JohnGENZ/695-Waffle-Meter/WaffleMeter V3 Board Layout/SpeechAnalyserV3.pdf

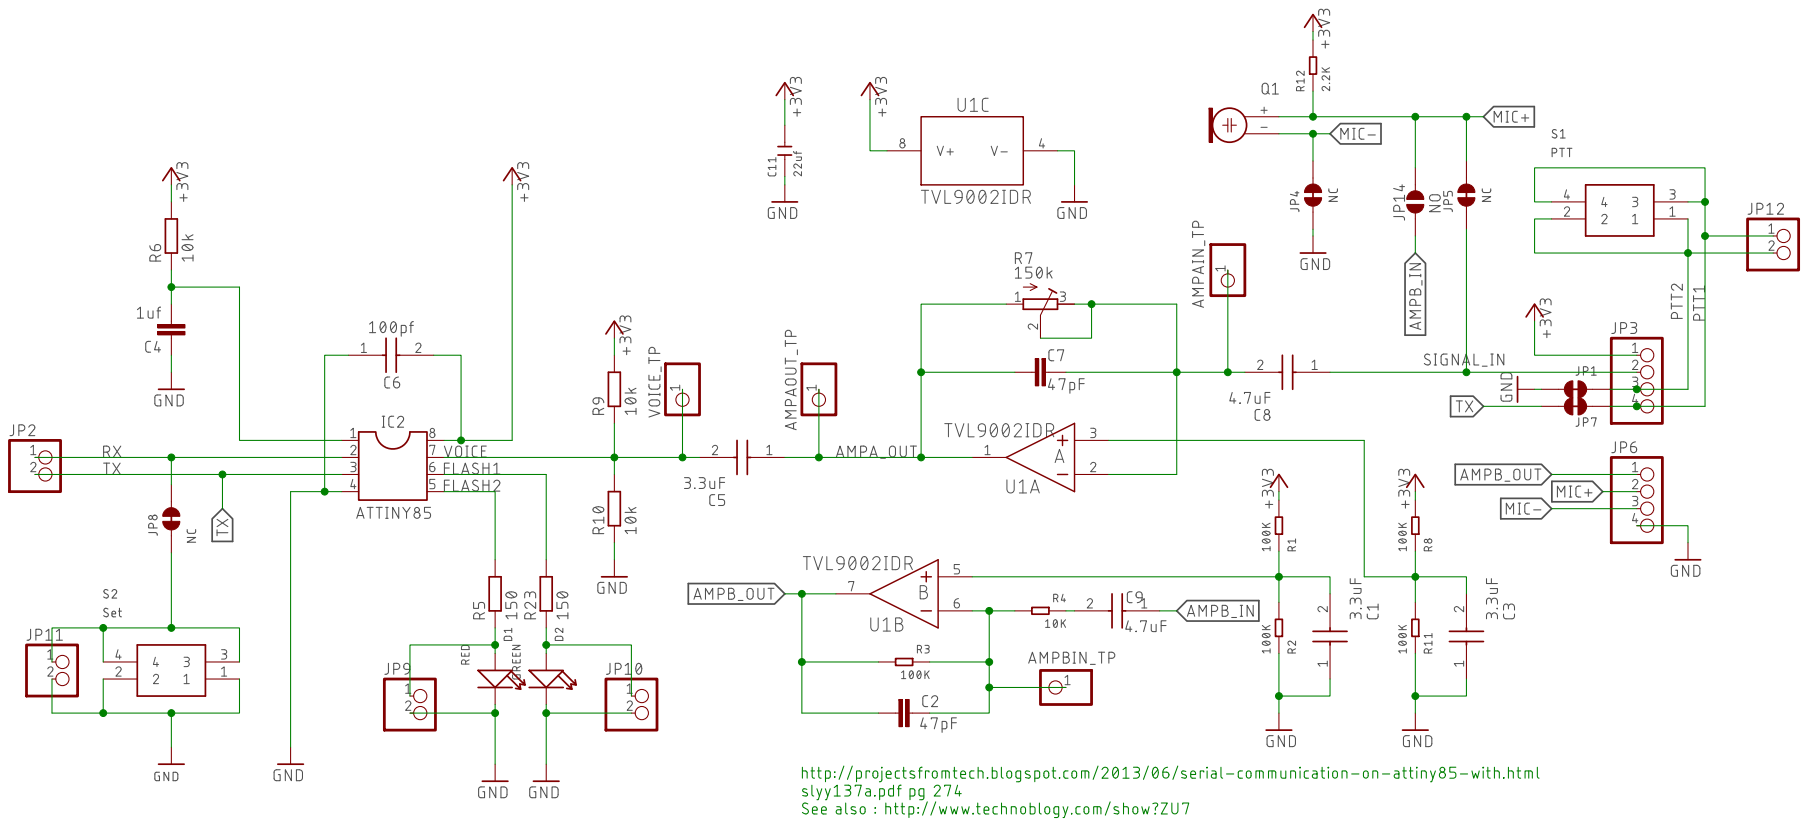
[picture p1: page 1]
