JohnGENZ/695-Waffle-Meter/WaffleMeter V3 Board Layout/SpeechAnalyserV3.brd

## EAGLE design WaffleMeter V3 Board Layout/SpeechAnalyserV3.brd (2020-05-19)

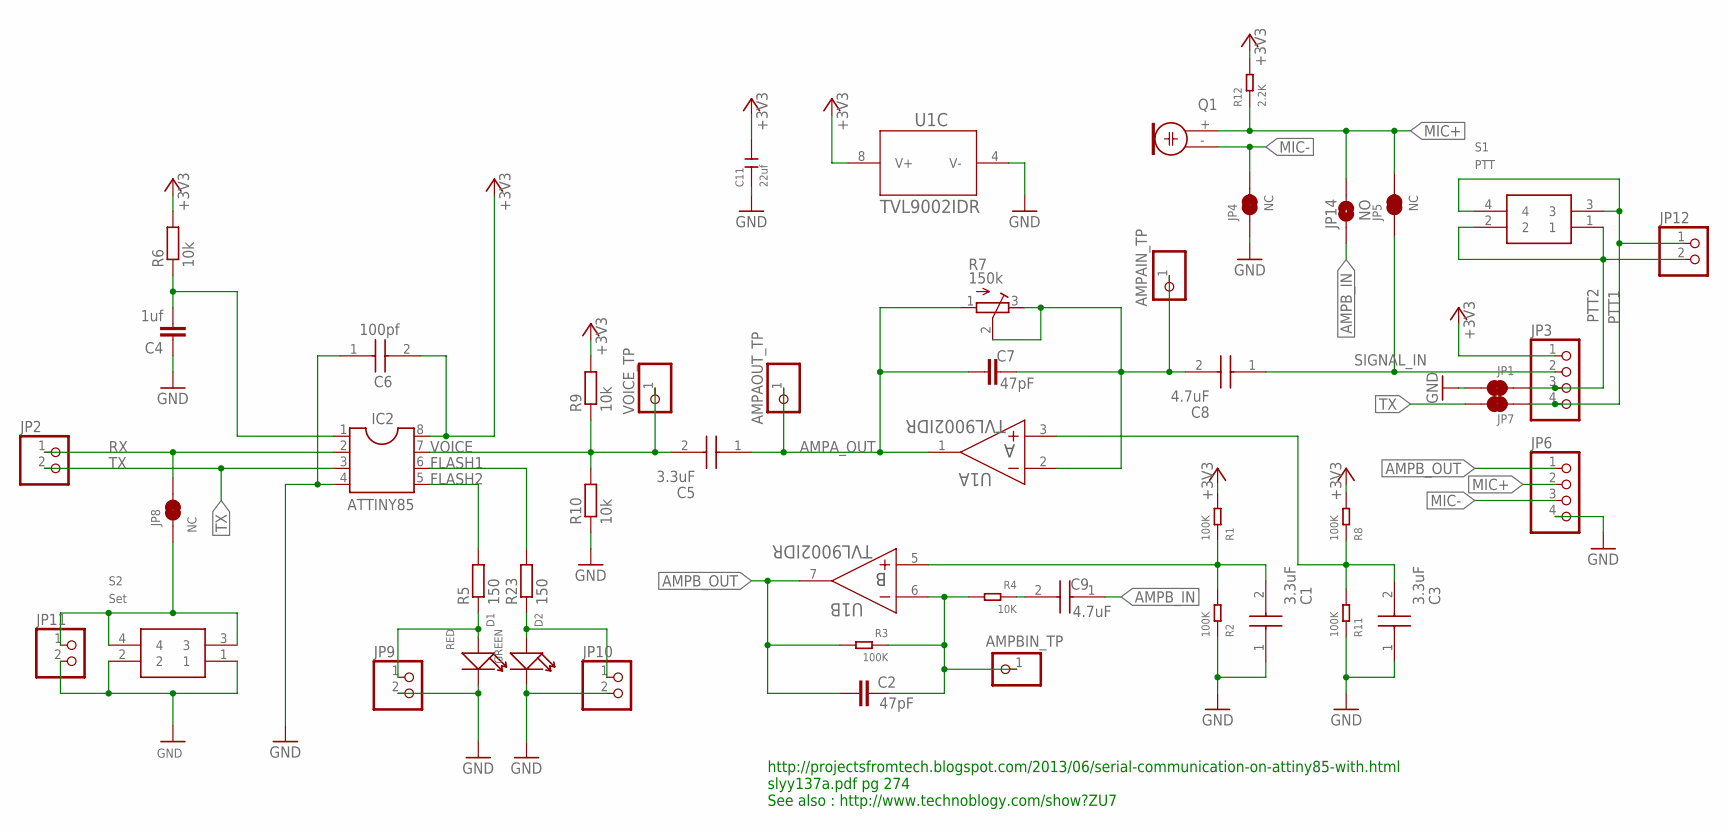
[picture p2: schematic SpeechAnalyserV3.sch]

Parts:
AMPA_IN: AMPAIN_TP; 1X01
AMPA_OUT: AMPAOUT_TP; 1X01
AMPB_IN: AMPBIN_TP; 1X01
C1, C3, C5: 3.3uF; CAPC2013X140N
C2, C7: 47pF; C0805
C4: 1uf; C0805
C6: 100pf; CAPC2012X90N
C8, C9: 4.7uF; CAPC2013X140N
C11: 22uf; C1206
D1: RED; LED-0805
D2: GREEN; LED-0805
IC2: ATTINY85; SOCKET-08
JP1, JP4, JP5, JP7, JP8: NC; SMT-JUMPER_2_NC_TRACE_SILK
JP2, JP9, JP10, JP11, JP12: PINHD-1X2; 1X02
JP3, JP6: PINHD-1X4; 1X04
JP14: NO; SMT-JUMPER_2_NO_SILK
Q1: ELECTRET; 9.7ELECTRET
R1, R2, R3, R8, R11: 100K; R0805
R4: 10K; R0805
R5, R23: 150; R0805
R6, R9, R10: 10k; R0805
R7: 150k; RTRIM64W
R12: 2.2K; R0805
S1: PTT; B3FS-1000P
S2: Set; B3FS-1000P
U1: TVL9002IDR; D0008A_N
VOICE: VOICE_TP; 1X01

Connections:
+3V3: C6.2, C11.2, IC2.8, JP3.1, R1.2, R6.2, R8.2, R9.2, R12.2, U1.8 (V+)
AMPA_OUT: AMPA_OUT.1, C5.1 (C1), C7.1, R7.1 (A), U1.1 (OUT)
AMPB_IN: C9.1 (C1), JP14.1
AMPB_OUT: C2.1, JP6.1, R3.2, U1.7 (OUT)
FLASH1: IC2.6, R23.2
FLASH2: IC2.5, R5.2
GND: C1.1 (C1), C3.1 (C1), C4.1, C6.1, C11.1, D1.-, D2.-, IC2.4, JP1.1, JP4.1, JP6.4, JP9.2, JP10.2, JP11.2, R2.1, R10.1, R11.1, S2.1, S2.2, U1.4 (V-)
MIC+: JP5.2, JP6.2, JP14.2, Q1.+ (2), R12.1
MIC-: JP4.2, JP6.3, Q1.- (1)
unnamed: C9.2 (C2), R4.1
unnamed: C3.2 (C2), R8.1, R11.2, U1.3 (IN+)
unnamed: C1.2 (C2), R1.1, R2.2, U1.5 (IN+)
unnamed: AMPB_IN.1, C2.2, R3.1, R4.2, U1.6 (IN-)
unnamed: D1.+, JP9.1, R5.1
unnamed: D2.+, JP10.1, R23.1
unnamed: AMPA_IN.1, C7.2, C8.2 (C2), R7.2 (S), R7.3 (E), U1.2 (IN-)
unnamed: C4.2, IC2.1, R6.1
unnamed: JP8.1, JP11.1, S2.3, S2.4
PTT1: JP3.4, JP7.2, JP12.1, S1.3, S1.4
PTT2: JP1.2, JP3.3, JP12.2, S1.1, S1.2
RX: IC2.2, JP2.1, JP8.2
SIGNAL_IN: C8.1 (C1), JP3.2, JP5.1
TX: IC2.3, JP2.2, JP7.1
VOICE: C5.2 (C2), IC2.7, R9.1, R10.2, VOICE.1

Notes on the sheet:
http://projectsfromtech.blogspot.com/2013/06/serial-communication-on-attiny85-with.html slyy137a.pdf pg 274 See also : http://www.technoblogy.com/show?ZU7

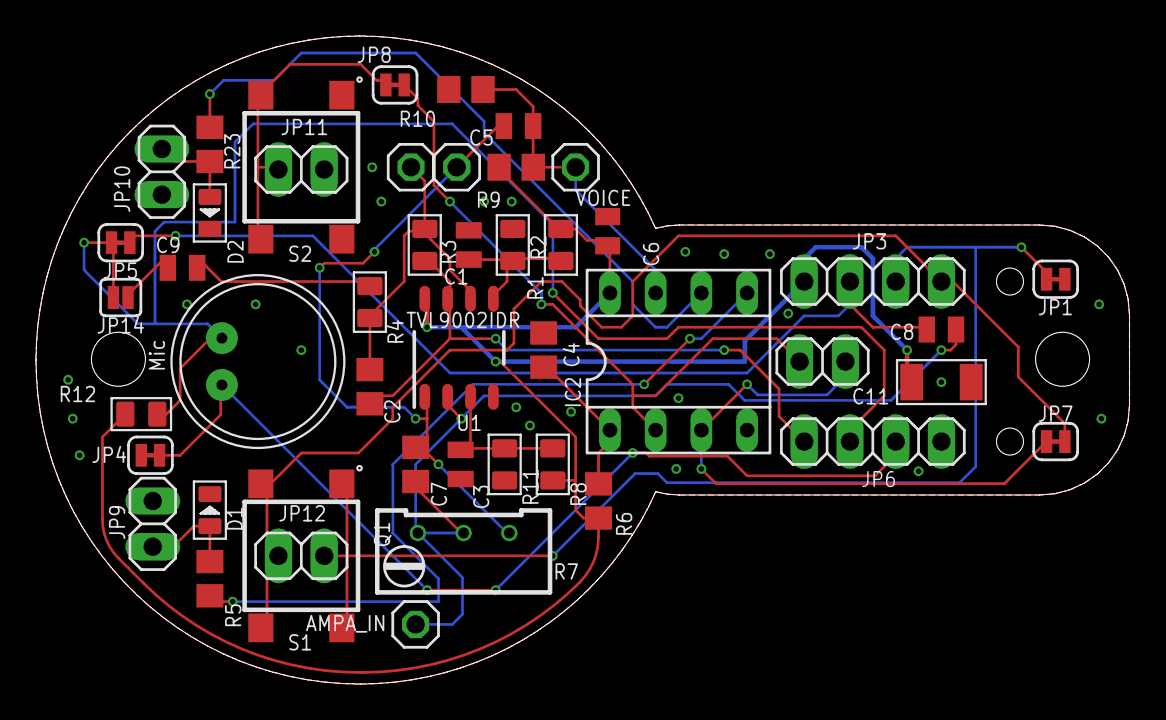
[picture p3: board SpeechAnalyserV3.brd from above]

Board: 4 copper layers, 60.8 x 36.0 mm, 47 parts (0 on the bottom side), 24 nets.
