JohnGENZ/695-Waffle-Meter/BiscuitV280/BiscuitEnvironmentConfig_V280.h

/******************************************************************
 Created with PROGRAMINO IDE for Arduino - 22.01.2018 15:29:25
 Libraries   :
 Author      :
 Description :
******************************************************************/
// Top of EEPROM used 
const int TopOfEEPROM = 512;

// Enable Debug Printing from the file system
const boolean FileSystemDebugPrint = false;      

// Maximum Size for a task name
const int MaxTaskNameSize = 40;

// Set up flag to indicate Task not known to command processor
const int TaskNotKnown = -1;

// Number of bytes in console message
const int ConsoleMessageBytes = 40;

// Set state of Switches when on and off
const int SET_Switch_ON = HIGH;
const int SET_Switch_OFF = LOW;
const int PTT_Switch_ON = HIGH;
const int PTT_Switch_OFF = LOW;   
