JohnGENZ/695-Waffle-Meter/BiscuitV280/BuildConfig_V280.h

/******************************************************************
 Created with PROGRAMINO IDE for Arduino - 01.02.2017 17:29:58
 Libraries   :
 Author      :
 Description :
******************************************************************/
// Set Debug Level
const int DEBUGLEVEL = 1;

// Build version
const String ThisBuild = "695W|VB2.800";  

// Version of NVS storage
const int NVSVersionThisBuild = 2;
// Set this flag to check the NVS version on startup
const boolean CheckNVSVersion = true;
