JohnGENZ/695-Waffle-Meter/BiscuitV280/ButtonsConfig_V280.h

/******************************************************************
 Created with PROGRAMINO IDE for Arduino - 13.08.2017 11:28:20
 Libraries   :
 Author      :
 Description :
******************************************************************/
/*
Reference:


*/

// Config Constants

// Delay before Buttons task starts (mS)
const int ButtonsStartmS = 250;

// Buttons task normal run rate (mS)
const int ButtonsRunRatemS = 25;

// The number of times a Button is read to get a stable read
const int ButtonsReadCount = 3;
