JohnGENZ/695-Waffle-Meter/BiscuitV280/ButtonsData_V280.h

/******************************************************************
 Created with PROGRAMINO IDE for Arduino - 20.06.2017 11:25:44
 Libraries   :
 Author      :
 Description :
******************************************************************/
/*
Reference:


*/


      // Buttons Control Structure 
      struct ButtonsControlStruct {

            };
            
      ButtonsControlStruct ButtonsControl;

      // Buttons Data Structure 
      struct ButtonsDataStruct {
            int SET_SwitchState;                       // SET_Switch state.  1 = open, 0 = closed, -1 = don't know
            int PTT_SwitchState;                       // PTT_Switch state.  1 = open, 0 = closed, -1 = don't know

            };
            
      ButtonsDataStruct ButtonsData;
      
 
