JohnGENZ/695-Waffle-Meter/BiscuitV280/InsideOutConfig_V280.h

/******************************************************************
 Created with PROGRAMINO IDE for Arduino - 13.08.2017 11:28:20
 Libraries   :
 Author      :
 Description :
******************************************************************/
/*
Reference:


*/

// Config Constants

// Delay before InsideOut task starts (mS)
const int InsideOutStartmS = 1000;

// InsideOut task normal run rate (mS)
const int InsideOutRunRatemS = 1000;

// Length of an InsideOut "bit" in mS - this code is blocking - keep it short and only use for diagnostics
const int InsideOutBitLengthmS = 4;
