JohnGENZ/695-Waffle-Meter/BiscuitV280/InsideOutData_V280.h

/******************************************************************
 Created with PROGRAMINO IDE for Arduino - 20.06.2017 11:25:44
 Libraries   :
 Author      :
 Description :
******************************************************************/
/*
Reference:


*/


      // InsideOut Control Structure 
      struct InsideOutControlStruct {


            };
            
      InsideOutControlStruct InsideOutControl;

      // InsideOut Data Structure 
      struct InsideOutDataStruct {


            };
            
      InsideOutDataStruct InsideOutData;
      
 
