JohnGENZ/695-Waffle-Meter/BiscuitV280/LightsData_V280.h

/******************************************************************
 Created with PROGRAMINO IDE for Arduino - 20.06.2017 11:25:44
 Libraries   :
 Author      :
 Description :
******************************************************************/
/*
Reference:


*/


      // Lights Control Structure 
      struct LightsControlStruct {


            };
            
      LightsControlStruct LightsControl;

      // Lights Data Structure 
      struct LightsDataStruct {


            };
            
      LightsDataStruct LightsData;
      
 
