JohnGENZ/695-Waffle-Meter/BiscuitV280/RedFlashData_V280.h

/******************************************************************
 Created with PROGRAMINO IDE for Arduino - 20.06.2017 11:25:44
 Libraries   :
 Author      :
 Description :
******************************************************************/
/*
Reference:


*/

      // RedFlash Control Structure 
      struct RedFlashControlStruct {


            };
            
      RedFlashControlStruct RedFlashControl;

      // RedFlash Data Structure 
      struct RedFlashDataStruct {


            };
            
      RedFlashDataStruct RedFlashData;
      
 
